kinged0043/robot_audio_subsystem/images/audio_board_signal_connections.png

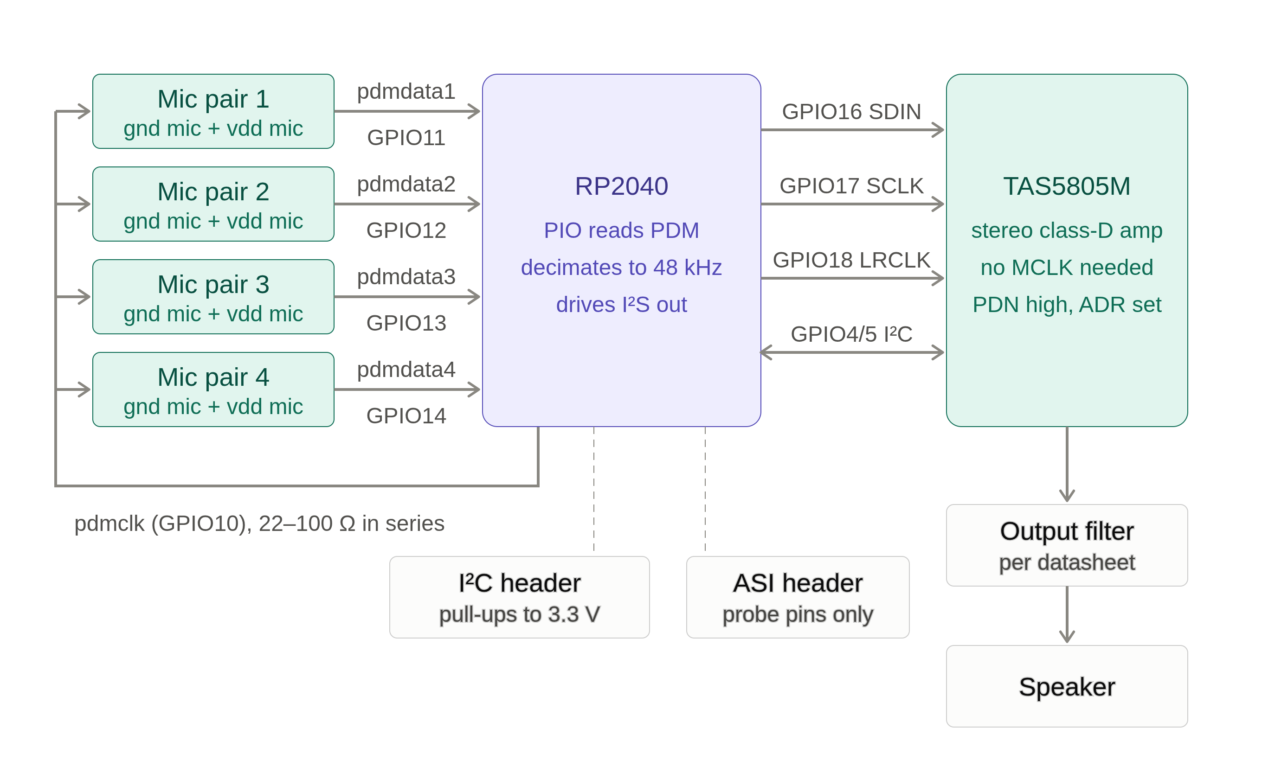
images/audio_board_signal_connections.png
