kinged0043/robot_audio_subsystem/images/rp2040_power_and_support_parts.png

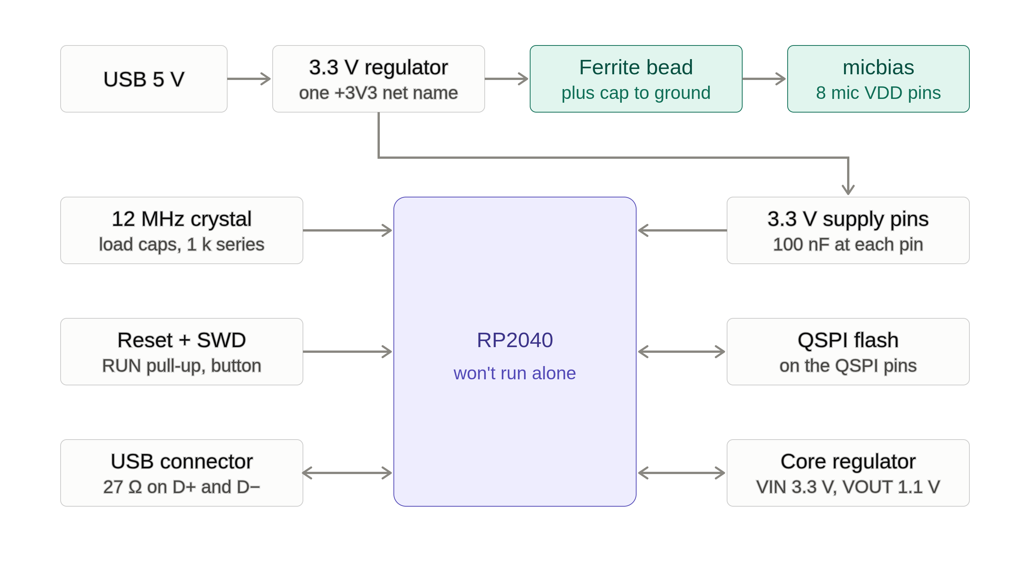
images/rp2040_power_and_support_parts.png
