kinged0043/robot_audio_subsystem/audio_subsystems_schematics/audio_subsystems_schematics (copy).kicad_sch

## KiCad design audio_subsystems_schematics/audio_subsystems_schematics (copy).kicad_sch (2026-10-11)

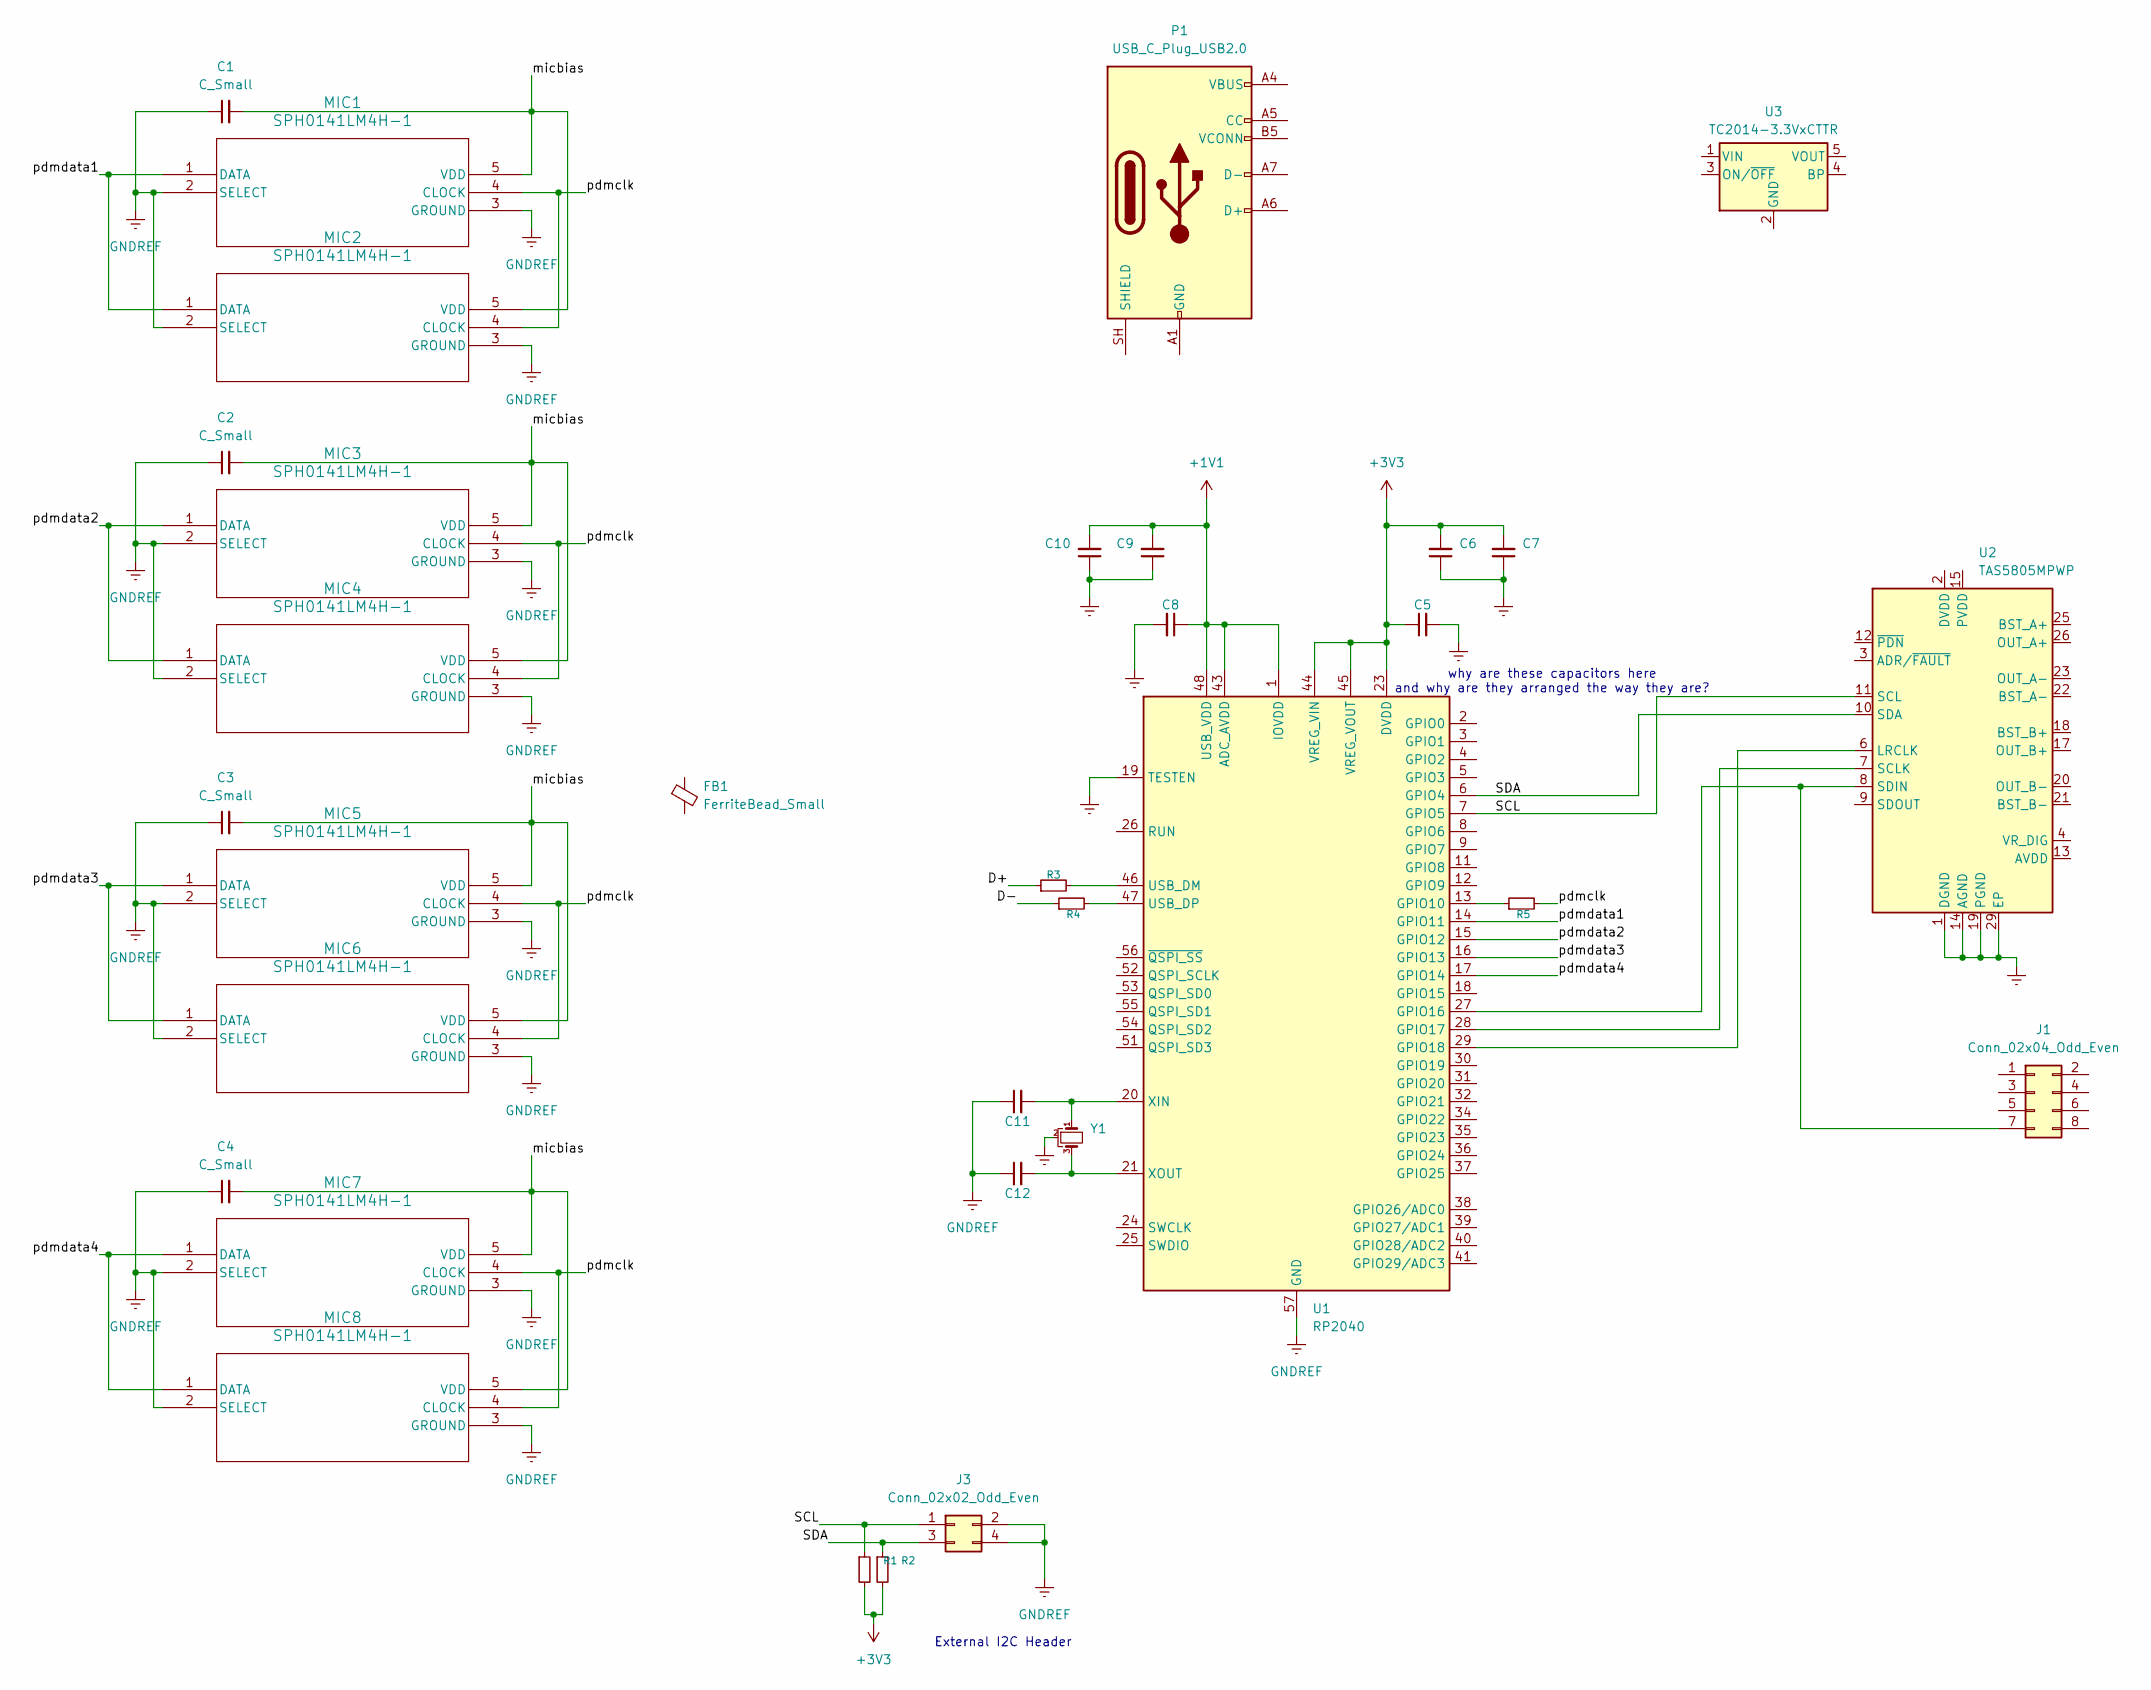
[picture p4: schematic audio_subsystems_schematics (copy).kicad_sch]

Parts:
C1, C2, C3, C4, C5, C6, C7, C8, C9, C10, C11, C12: C_Small
FB1: FerriteBead_Small
J1: Conn_02x04_Odd_Even
J3: Conn_02x02_Odd_Even
MIC1, MIC2, MIC3, MIC4, MIC5, MIC6, MIC7, MIC8: SPH0141LM4H-1; SPH0141LM4H-1_KNO
P1: USB_C_Plug_USB2.0
R1, R2, R3, R4, R5: R_Small
U1: RP2040; QFN-56-1EP_7x7mm_P0.4mm_EP3.2x3.2mm
U2: TAS5805MPWP; TSSOP-28-1EP_4.4x9.7mm_P0.65mm_EP3.4x9.7mm_Mask3.1x4.05mm_T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
U3: TC2014-3.3VxCTTR; SOT-23-5
Y1: Crystal_GND2_Small

Connections:
+1V1: C8.1, C9.2, C10.2, U1.1 (IOVDD), U1.10 (IOVDD), U1.22 (IOVDD), U1.33 (IOVDD), U1.42 (IOVDD), U1.43 (ADC_AVDD), U1.48 (USB_VDD), U1.49 (IOVDD)
+3V3: C5.1, C6.2, C7.2, R1.2, R2.2, U1.23 (DVDD), U1.44 (VREG_VIN), U1.45 (VREG_VOUT), U1.50 (DVDD)
D+: R3.1
D-: R4.1
GNDREF: C1.1, C2.1, C3.1, C4.1, C5.2, C6.1, C7.1, C8.2, C9.1, C10.1, C11.1, C12.1, J3.2, J3.4, MIC1.2 (SELECT), MIC1.3 (GROUND), MIC2.2 (SELECT), MIC2.3 (GROUND), MIC3.2 (SELECT), MIC3.3 (GROUND), MIC4.2 (SELECT), MIC4.3 (GROUND), MIC5.2 (SELECT), MIC5.3 (GROUND), MIC6.2 (SELECT), MIC6.3 (GROUND), MIC7.2 (SELECT), MIC7.3 (GROUND), MIC8.2 (SELECT), MIC8.3 (GROUND), U1.19 (TESTEN), U1.57 (GND), U2.1 (DGND), U2.5 (DGND), U2.14 (AGND), U2.19 (PGND), U2.24 (PGND), U2.29 (EP), Y1.2
unnamed: C11.2, U1.20 (XIN), Y1.1
unnamed: C12.2, U1.21 (XOUT), Y1.3
unnamed: J1.7, U1.27 (GPIO16), U2.8 (SDIN)
unnamed: P1.A1 (GND), P1.A12 (GND), P1.B1 (GND), P1.B12 (GND)
unnamed: P1.A4 (VBUS), P1.A9 (VBUS), P1.B4 (VBUS), P1.B9 (VBUS)
unnamed: R3.2, U1.46 (USB_DM)
unnamed: R4.2, U1.47 (USB_DP)
unnamed: R5.1, U1.13 (GPIO10)
unnamed: U1.28 (GPIO17), U2.7 (SCLK)
unnamed: U1.29 (GPIO18), U2.6 (LRCLK)
unnamed: U2.15 (PVDD), U2.16 (PVDD), U2.27 (PVDD), U2.28 (PVDD)
SCL: J3.1, R1.1, U1.7 (GPIO5), U2.11 (SCL)
SDA: J3.3, R2.1, U1.6 (GPIO4), U2.10 (SDA)
micbias: C1.2, C2.2, C3.2, C4.2, MIC1.5 (VDD), MIC2.5 (VDD), MIC3.5 (VDD), MIC4.5 (VDD), MIC5.5 (VDD), MIC6.5 (VDD), MIC7.5 (VDD), MIC8.5 (VDD)
pdmclk: MIC1.4 (CLOCK), MIC2.4 (CLOCK), MIC3.4 (CLOCK), MIC4.4 (CLOCK), MIC5.4 (CLOCK), MIC6.4 (CLOCK), MIC7.4 (CLOCK), MIC8.4 (CLOCK), R5.2
pdmdata1: MIC1.1 (DATA), MIC2.1 (DATA), U1.14 (GPIO11)
pdmdata2: MIC3.1 (DATA), MIC4.1 (DATA), U1.15 (GPIO12)
pdmdata3: MIC5.1 (DATA), MIC6.1 (DATA), U1.16 (GPIO13)
pdmdata4: MIC7.1 (DATA), MIC8.1 (DATA), U1.17 (GPIO14)

Notes on the sheet:
why are these capacitors here and why are they arranged the way they are?
External I2C Header
