kinged0043/robot_audio_subsystem/audio_subsystems_schematics/audio_subsystems_schematics.kicad_sch

## KiCad design audio_subsystems_schematics/audio_subsystems_schematics.kicad_sch (2026-10-11)

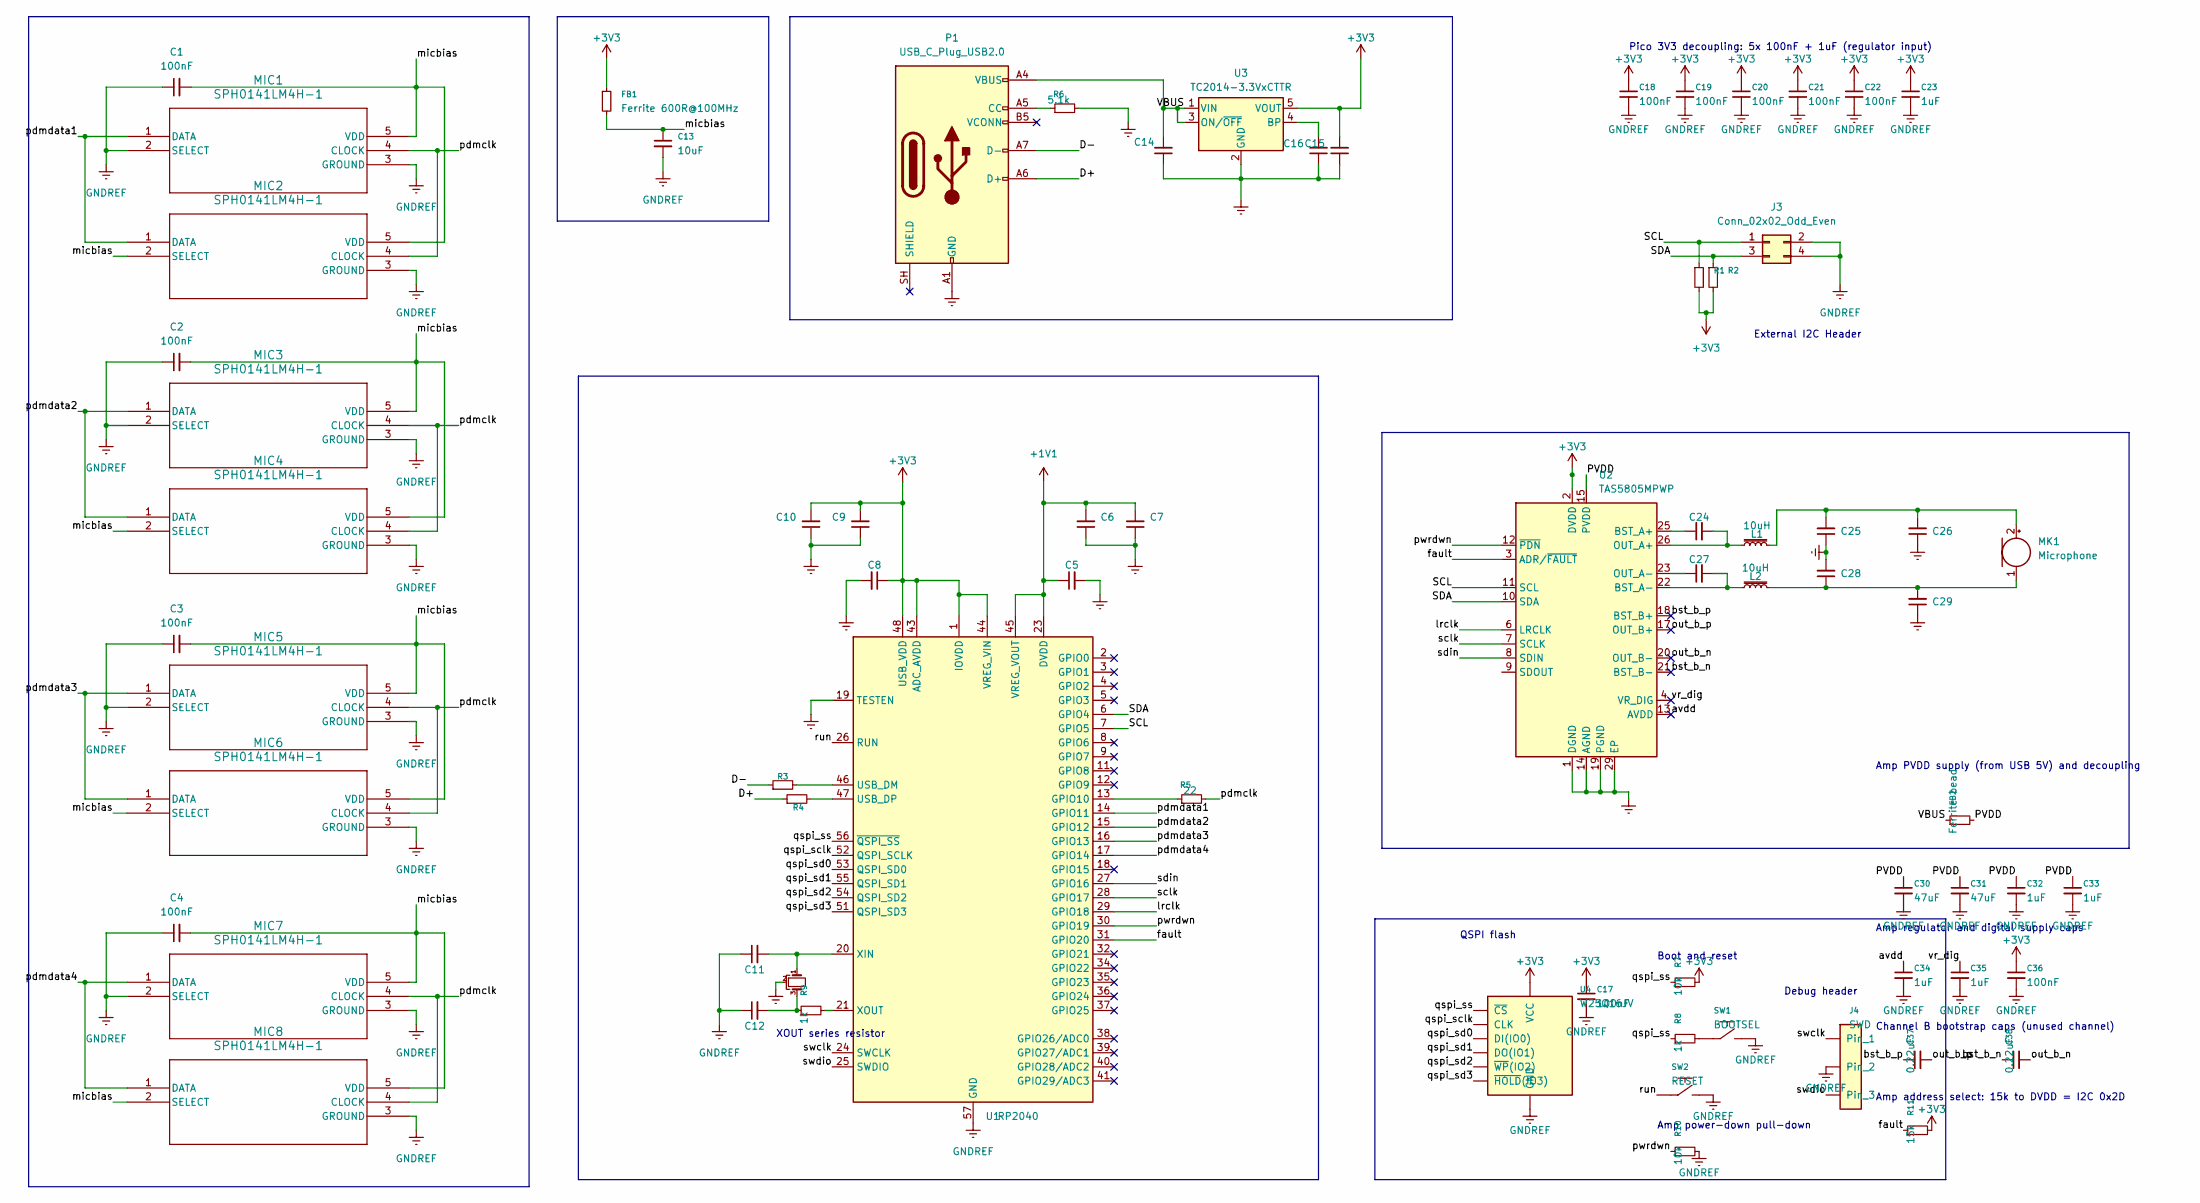
[picture p5: schematic audio_subsystems_schematics.kicad_sch]

Parts:
C1, C2, C4, C5, C6, C8, C9, C10, C17, C18, C19, C20, C21, C22, C36: 100nF
C3: 100nF; C_0201_0603Metric
C7, C23, C32, C33, C34, C35: 1uF
C11, C12: 15pF
C13: 10uF
C14, C15, C16: C_Small
C24, C27, C37, C38: 0.22uF
C25, C28: 0.68uF
C26, C29: 1nF
C30, C31: 47uF
FB1: Ferrite 600R@100MHz
FB2: Ferrite bead
J3: Conn_02x02_Odd_Even; PinHeader_2x02_P1.00mm_Vertical
J4: SWD
L1, L2: 10uH
MIC1, MIC2, MIC3, MIC4, MIC6, MIC7, MIC8: SPH0141LM4H-1; SPH0141LM4H-1_KNO
MIC5: SPH0141LM4H-1; Knowles_SPH0645LM4H-6_3.5x2.65mm
MK1: Microphone
P1: USB_C_Plug_USB2.0
R1, R2: 4.7k
R3, R4: 27
R5: 22
R6: 5.1k
R7, R10: 10k
R8, R9: 1k
R11: 15k
SW1: BOOTSEL
SW2: RESET
U1: RP2040; QFN-56-1EP_7x7mm_P0.4mm_EP3.2x3.2mm
U2: TAS5805MPWP; TSSOP-28-1EP_4.4x9.7mm_P0.65mm_EP3.4x9.7mm_Mask3.1x4.05mm_T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
U3: TC2014-3.3VxCTTR; SOT-23-5
U4: W25Q16JV; SOIC-8_5.3x5.3mm_P1.27mm
Y1: Crystal_GND2_Small

Connections:
+1V1: C5.1, C6.2, C7.2, U1.23 (DVDD), U1.45 (VREG_VOUT), U1.50 (DVDD)
+3V3: C8.1, C9.2, C10.2, C15.2, C17.1, C18.1, C19.1, C20.1, C21.1, C22.1, C23.1, C36.1, FB1.1, R1.2, R2.2, R7.2, R11.2, U1.1 (IOVDD), U1.10 (IOVDD), U1.22 (IOVDD), U1.33 (IOVDD), U1.42 (IOVDD), U1.43 (ADC_AVDD), U1.44 (VREG_VIN), U1.48 (USB_VDD), U1.49 (IOVDD), U2.2 (DVDD), U3.5 (VOUT), U4.8 (VCC)
D+: P1.A6 (D+), R4.1
D-: P1.A7 (D-), R3.1
GNDREF: C1.1, C2.1, C3.1, C4.1, C5.2, C6.1, C7.1, C8.2, C9.1, C10.1, C11.1, C12.1, C13.2, C14.1, C15.1, C16.1, C17.2, C18.2, C19.2, C20.2, C21.2, C22.2, C23.2, C25.1, C26.1, C28.2, C29.1, C30.2, C31.2, C32.2, C33.2, C34.2, C35.2, C36.2, J3.2, J3.4, J4.2, MIC1.2 (SELECT), MIC1.3 (GROUND), MIC2.3 (GROUND), MIC3.2 (SELECT), MIC3.3 (GROUND), MIC4.3 (GROUND), MIC5.2 (SELECT), MIC5.3 (GROUND), MIC6.3 (GROUND), MIC7.2 (SELECT), MIC7.3 (GROUND), MIC8.3 (GROUND), P1.A1 (GND), P1.A12 (GND), P1.B1 (GND), P1.B12 (GND), R6.2, R10.2, SW1.2, SW2.2, U1.19 (TESTEN), U1.57 (GND), U2.1 (DGND), U2.5 (DGND), U2.14 (AGND), U2.19 (PGND), U2.24 (PGND), U2.29 (EP), U3.2 (GND), U4.4 (GND), Y1.2
unnamed: C11.2, U1.20 (XIN), Y1.1
unnamed: C12.2, R9.1, Y1.3
unnamed: C16.2, U3.4 (BP)
unnamed: C24.1, U2.25 (BST_A+)
unnamed: C24.2, L1.1, U2.26 (OUT_A+)
unnamed: C25.2, C26.2, L1.2, MK1.2 (+)
unnamed: C27.1, U2.23 (OUT_A-)
unnamed: C27.2, L2.1, U2.22 (BST_A-)
unnamed: C28.1, C29.2, L2.2, MK1.1 (-)
unnamed: P1.A5 (CC), R6.1
unnamed: R3.2, U1.46 (USB_DM)
unnamed: R4.2, U1.47 (USB_DP)
unnamed: R5.1, U1.13 (GPIO10)
unnamed: R8.2, SW1.1
unnamed: R9.2, U1.21 (XOUT)
PVDD: C30.1, C31.1, C32.1, C33.1, FB2.2, U2.15 (PVDD), U2.16 (PVDD), U2.27 (PVDD), U2.28 (PVDD)
SCL: J3.1, R1.1, U1.7 (GPIO5), U2.11 (SCL)
SDA: J3.3, R2.1, U1.6 (GPIO4), U2.10 (SDA)
VBUS: C14.2, FB2.1, P1.A4 (VBUS), P1.A9 (VBUS), P1.B4 (VBUS), P1.B9 (VBUS), U3.1 (VIN), U3.3 (ON/~OFF)
avdd: C34.1, U2.13 (AVDD)
bst_b_n: C38.1, U2.21 (BST_B-)
bst_b_p: C37.1, U2.18 (BST_B+)
fault: R11.1, U1.31 (GPIO20), U2.3 (ADR/~FAULT)
lrclk: U1.29 (GPIO18), U2.6 (LRCLK)
micbias: C1.2, C2.2, C3.2, C4.2, C13.1, FB1.2, MIC1.5 (VDD), MIC2.2 (SELECT), MIC2.5 (VDD), MIC3.5 (VDD), MIC4.2 (SELECT), MIC4.5 (VDD), MIC5.5 (VDD), MIC6.2 (SELECT), MIC6.5 (VDD), MIC7.5 (VDD), MIC8.2 (SELECT), MIC8.5 (VDD)
out_b_n: C38.2, U2.20 (OUT_B-)
out_b_p: C37.2, U2.17 (OUT_B+)
pdmclk: MIC1.4 (CLOCK), MIC2.4 (CLOCK), MIC3.4 (CLOCK), MIC4.4 (CLOCK), MIC5.4 (CLOCK), MIC6.4 (CLOCK), MIC7.4 (CLOCK), MIC8.4 (CLOCK), R5.2
pdmdata1: MIC1.1 (DATA), MIC2.1 (DATA), U1.14 (GPIO11)
pdmdata2: MIC3.1 (DATA), MIC4.1 (DATA), U1.15 (GPIO12)
pdmdata3: MIC5.1 (DATA), MIC6.1 (DATA), U1.16 (GPIO13)
pdmdata4: MIC7.1 (DATA), MIC8.1 (DATA), U1.17 (GPIO14)
pwrdwn: R10.1, U1.30 (GPIO19), U2.12 (~PDN)
qspi_sclk: U1.52 (QSPI_SCLK), U4.6 (CLK)
qspi_sd0: U1.53 (QSPI_SD0), U4.5 (DI(IO0))
qspi_sd1: U1.55 (QSPI_SD1), U4.2 (DO(IO1))
qspi_sd2: U1.54 (QSPI_SD2), U4.3 (~WP(IO2))
qspi_sd3: U1.51 (QSPI_SD3), U4.7 (~HOLD(IO3))
qspi_ss: R7.1, R8.1, U1.56 (~QSPI_SS), U4.1 (~CS)
run: SW2.1, U1.26 (RUN)
sclk: U1.28 (GPIO17), U2.7 (SCLK)
sdin: U1.27 (GPIO16), U2.8 (SDIN)
swclk: J4.1, U1.24 (SWCLK)
swdio: J4.3, U1.25 (SWDIO)
vr_dig: C35.1, U2.4 (VR_DIG)

Notes on the sheet:
XOUT series resistor
QSPI flash
Amp power-down pull-down
Boot and reset
Pico 3V3 decoupling: 5x 100nF + 1uF (regulator input)
External I2C Header
Debug header
Amp PVDD supply (from USB 5V) and decoupling
Amp regulator and digital supply caps
Channel B bootstrap caps (unused channel)
Amp address select: 15k to DVDD = I2C 0x2D
