kinged0043/robot_audio_subsystem/(commit log)

2026-10-11 schematics updated and finished
2026-10-11 Add firmware: USB audio with 4-mic capture and TAS5805M playback
    The board enumerates as a USB Audio Class 2 device: a 4-channel,
    48 kHz/16-bit microphone and a stereo speaker.
    - PIO drives the 3.072 MHz PDM clock and samples the 4 data lines;
    DMA moves raw bits in 1 ms blocks.
    - Core 1 keeps one mic per data line (MIC1, 3, 5, 7), runs a sinc^4
    decimation filter (lookup tables, inline asm), removes DC and
    outputs int16 PCM.
    - Speaker audio from USB is mixed to mono (only amp channel A has a
    speaker) and sent to the TAS5805M over PIO I2S, with a buffer that
    drops or repeats single samples to absorb host clock drift.
    - TAS5805M driver: power-up sequence, address probe, analog gain s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
2026-10-11 Power amp PVDD directly from VBUS
    Remove ferrite bead FB2 and the PVDD decoupling caps C30-C33; the
    TAS5805M PVDD pins now sit on VBUS with a 47 uF bulk cap (C39).
    No RP2040 pin assignments change.
    Drop KiCad lock and autosave files from the repo and ignore them,
    and add the latest KiCad backup.
